panchazo/open-weather-station/docs/img/110-220_power_cable.jpg

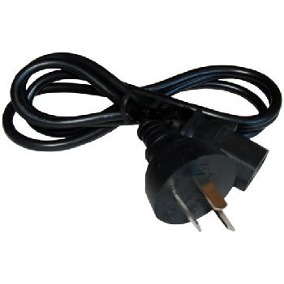
docs/img/110-220_power_cable.jpg
