panchazo/open-weather-station/docs/img/dual_usb_wall_socket_charger_module.jpg

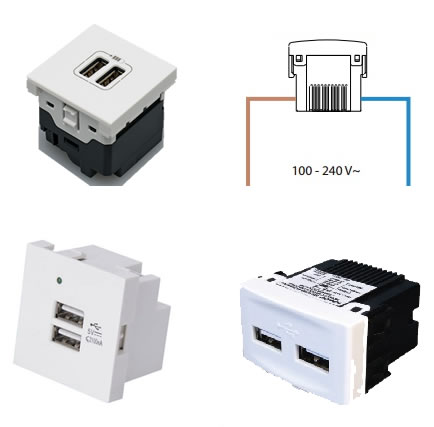
docs/img/dual_usb_wall_socket_charger_module.jpg
