panchazo/open-weather-station/docs/img/female_female_jumper_wires.jpg

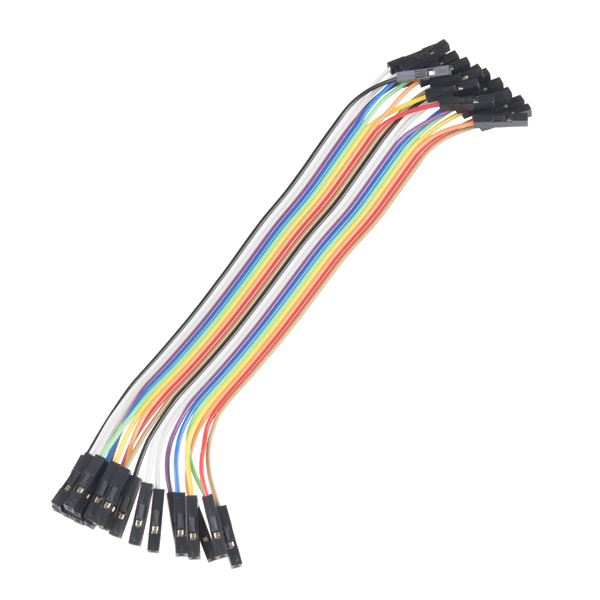
docs/img/female_female_jumper_wires.jpg
