panchazo/open-weather-station/docs/img/female_header_pins.jpg

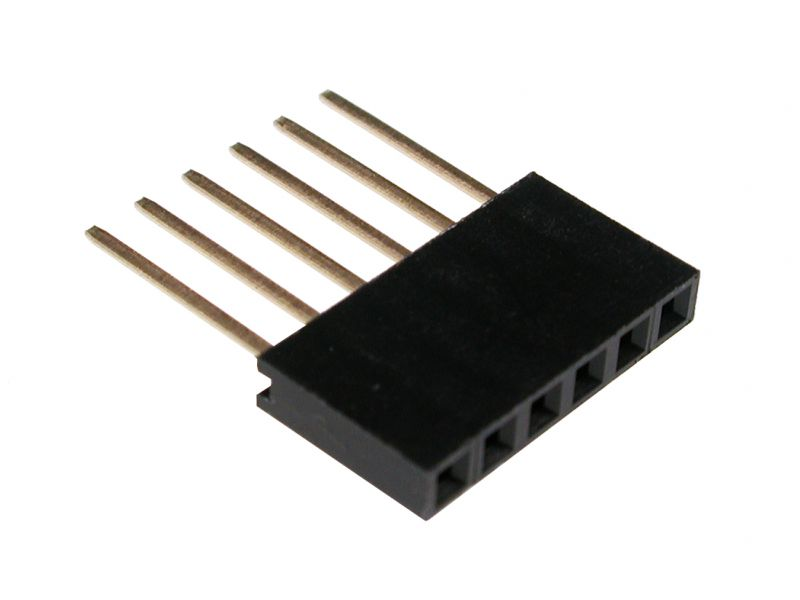
docs/img/female_header_pins.jpg
