panchazo/open-weather-station/docs/img/header_pins.jpg

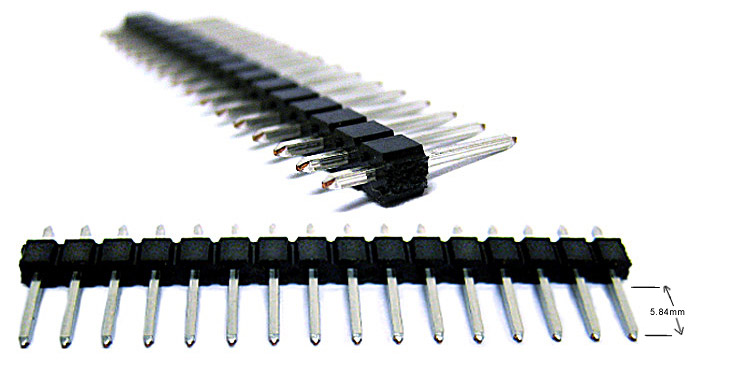
docs/img/header_pins.jpg
