panchazo/open-weather-station/docs/img/pcb_single_side_copper.jpg

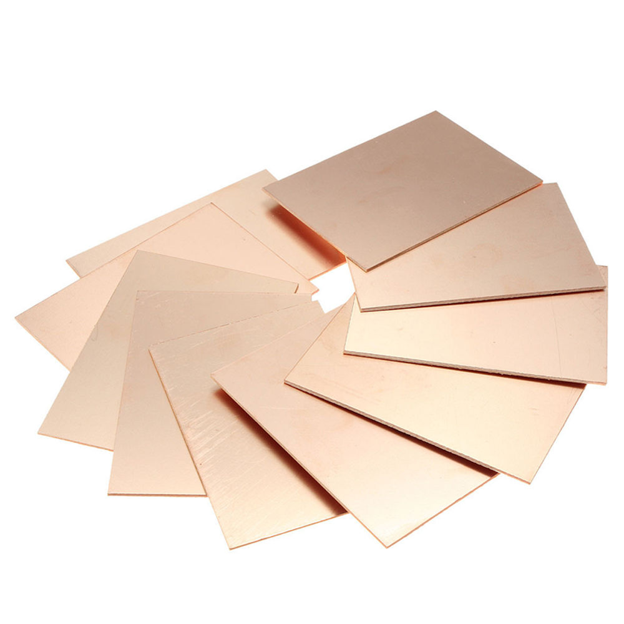
docs/img/pcb_single_side_copper.jpg
