panchazo/open-weather-station/docs/img/rj11_socket.jpg

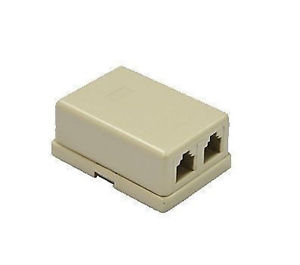
docs/img/rj11_socket.jpg
