panchazo/open-weather-station/docs/img/ws1080_anemometer.jpg

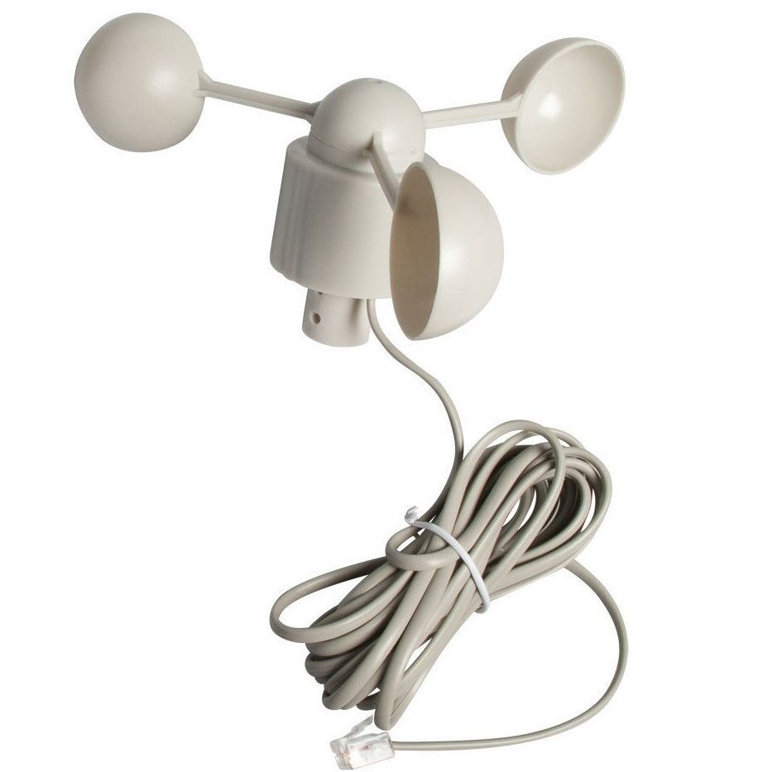
docs/img/ws1080_anemometer.jpg
