panchazo/open-weather-station/docs/img/ws1080_anemometer_windvane_support.jpg

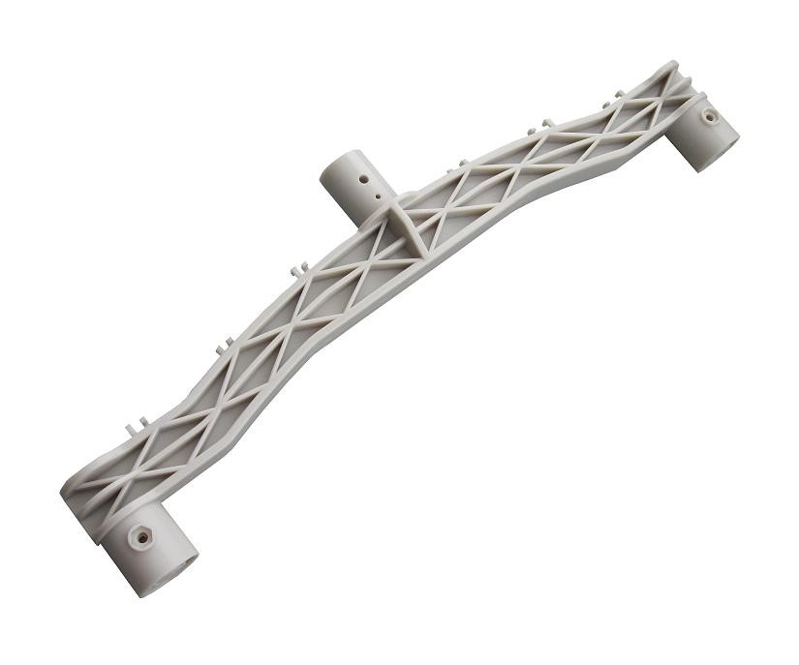
docs/img/ws1080_anemometer_windvane_support.jpg
