panchazo/open-weather-station/docs/img/ws1080_rain_gauge.jpg

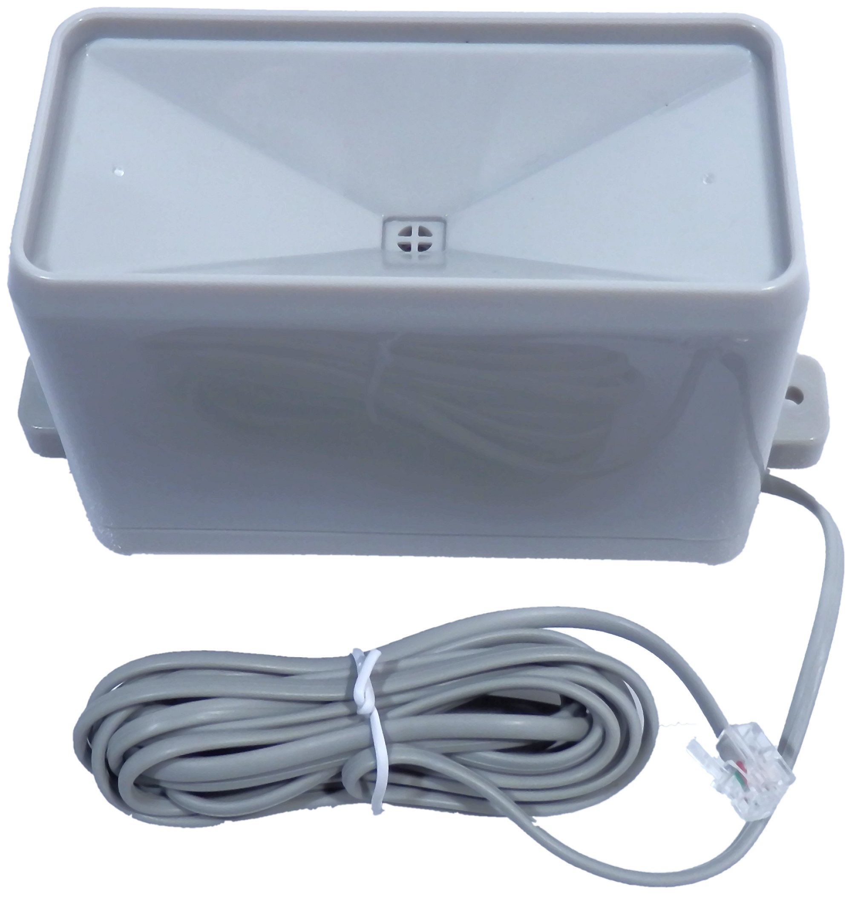
docs/img/ws1080_rain_gauge.jpg
