panchazo/open-weather-station/docs/img/ws1080_rain_gauge_support.jpg

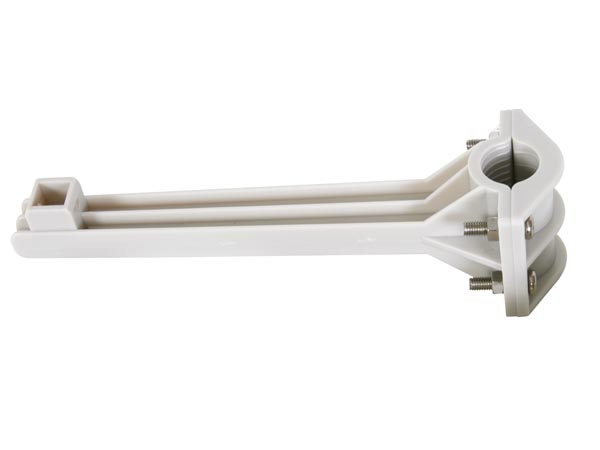
docs/img/ws1080_rain_gauge_support.jpg
