panchazo/open-weather-station/docs/img/ws1080_windvane.jpg

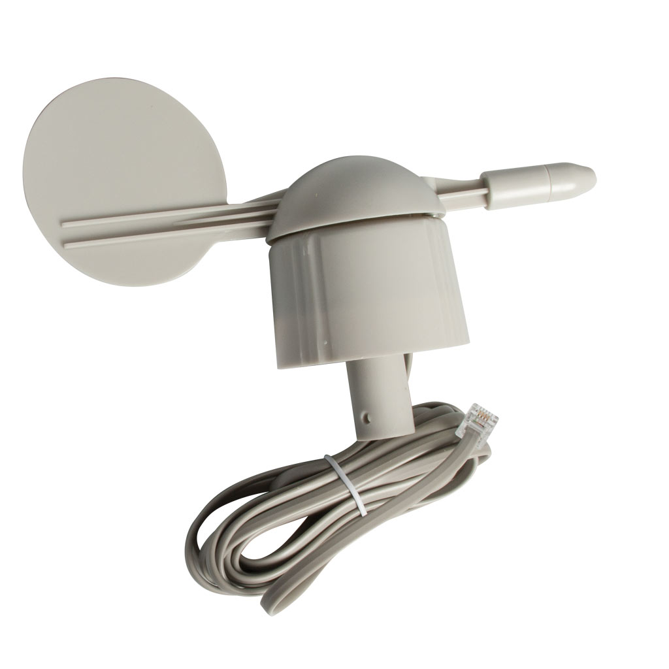
docs/img/ws1080_windvane.jpg
