panchazo/open-weather-station/docs/pcb printing sheet.pdf

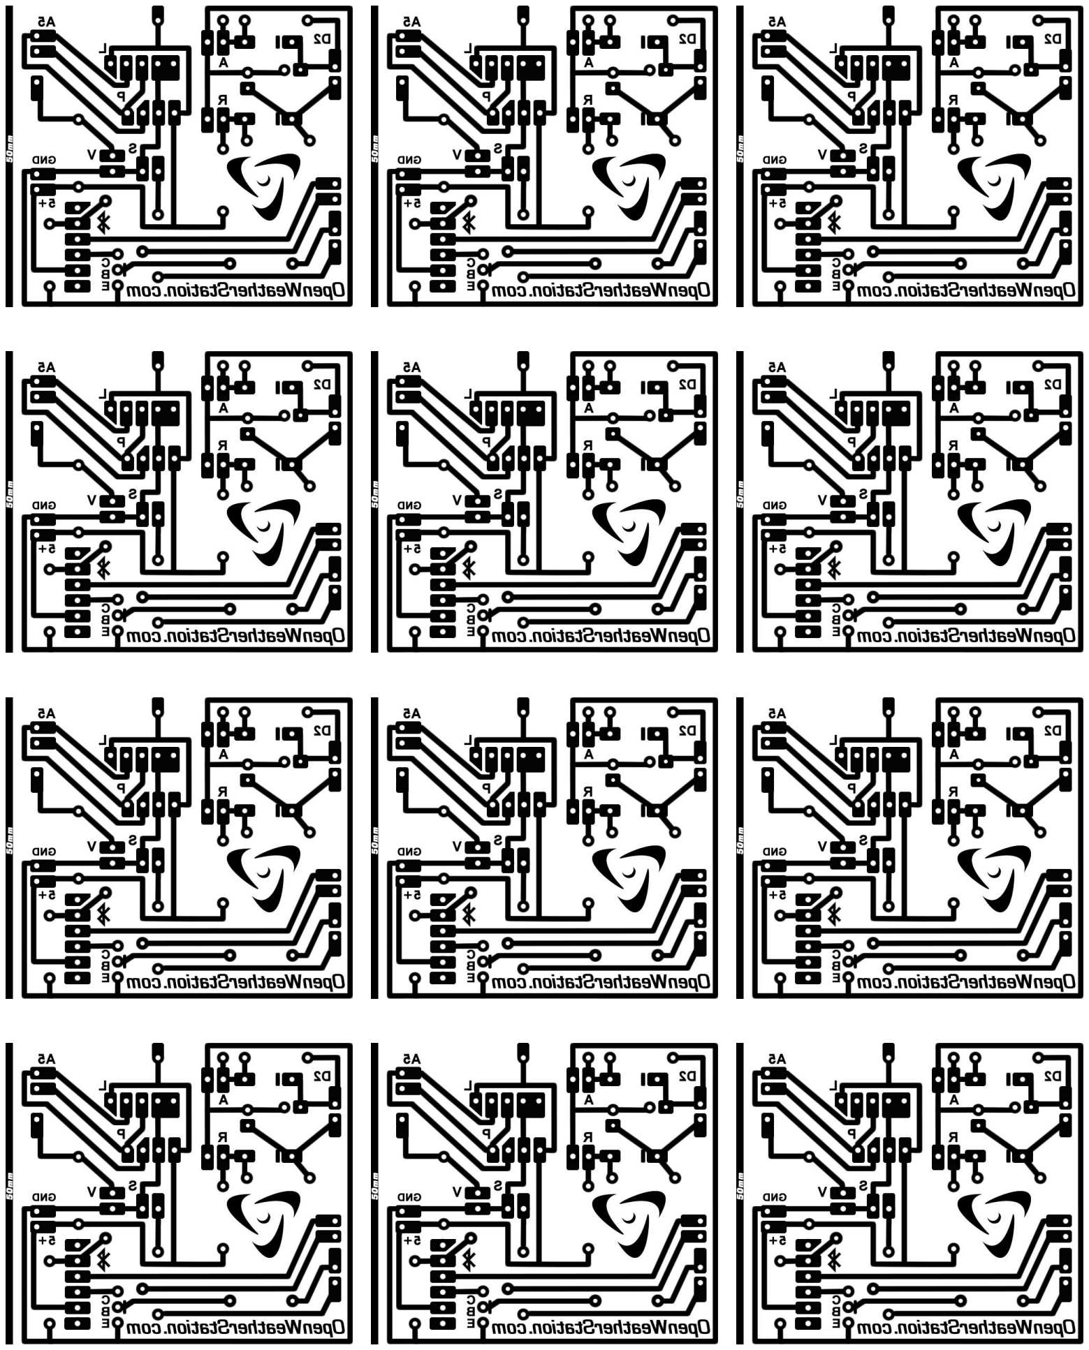
[picture p22: page 1]
