panchazo/open-weather-station/docs/img/assembly-step-by-step/1 - Etching and drilling/20180105_233544.jpg

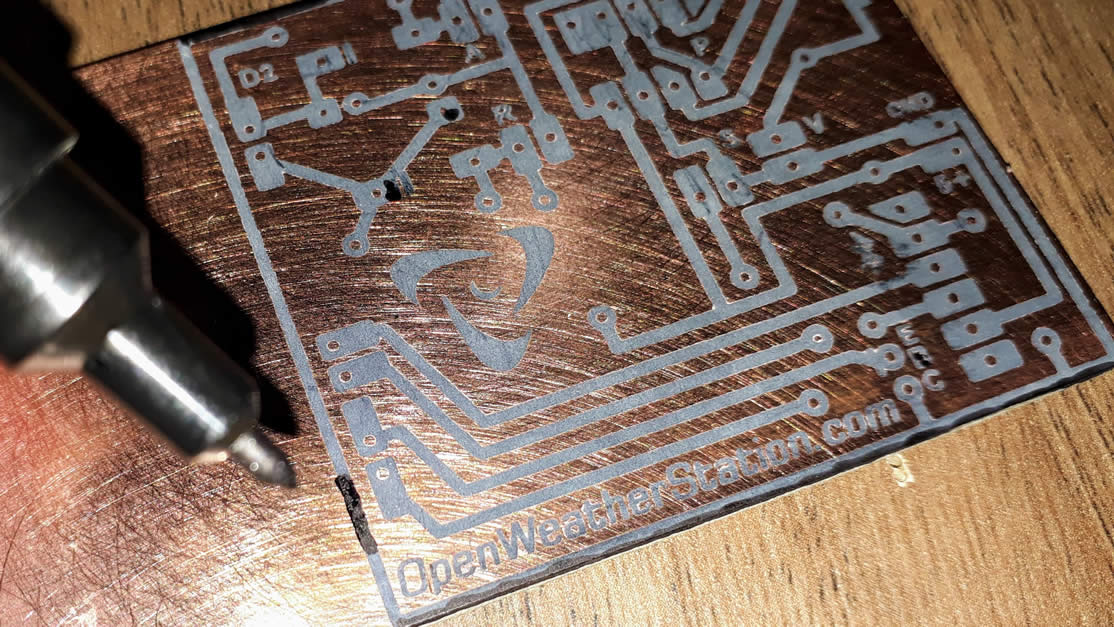
docs/img/assembly-step-by-step/1 - Etching and drilling/20180105_233544.jpg
