panchazo/open-weather-station/docs/img/assembly-step-by-step/1 - Etching and drilling/20180106_003709.jpg

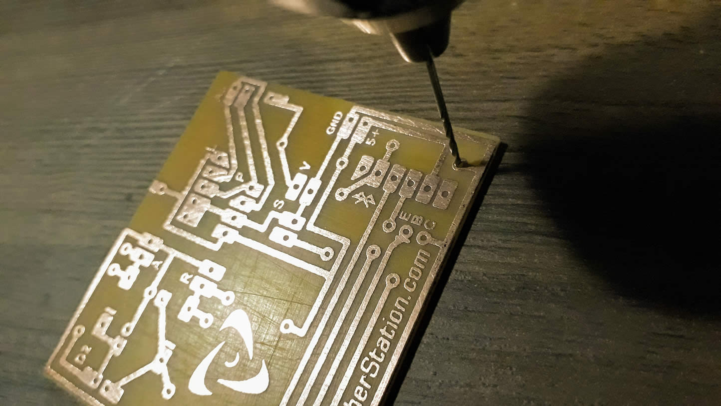
docs/img/assembly-step-by-step/1 - Etching and drilling/20180106_003709.jpg
