panchazo/open-weather-station/docs/img/assembly-step-by-step/1 - Etching and drilling/20180106_004929.jpg

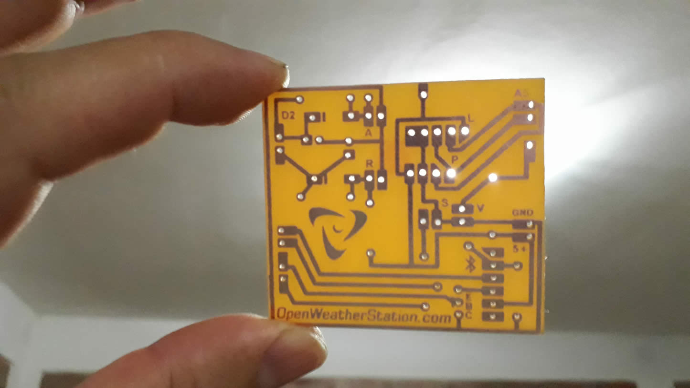
docs/img/assembly-step-by-step/1 - Etching and drilling/20180106_004929.jpg
