panchazo/open-weather-station/docs/img/assembly-step-by-step/2 - PCB header pins/20180106_012025.jpg

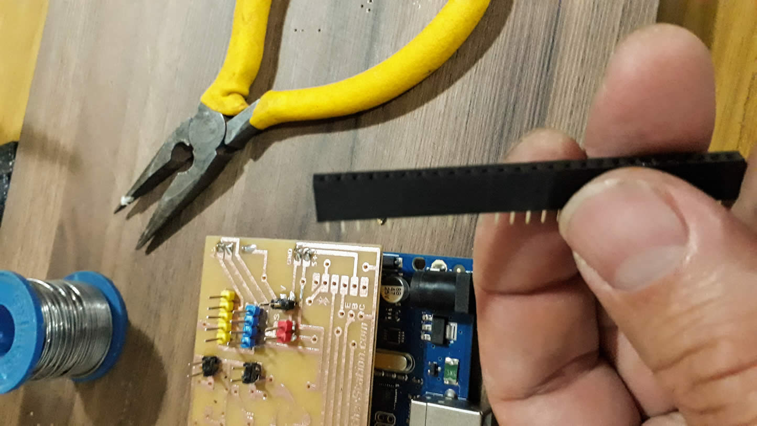
docs/img/assembly-step-by-step/2 - PCB header pins/20180106_012025.jpg
