panchazo/open-weather-station/docs/img/assembly-step-by-step/3 - Soldering components/20180106_014244.jpg

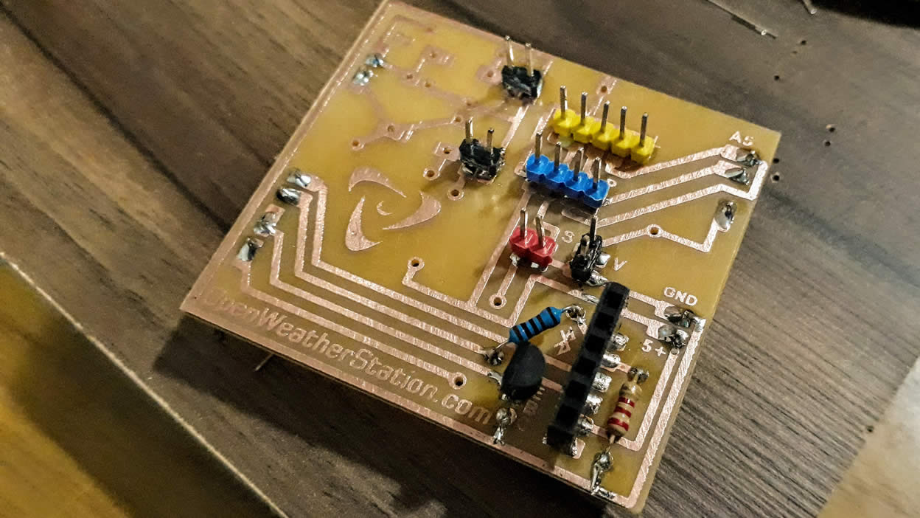
docs/img/assembly-step-by-step/3 - Soldering components/20180106_014244.jpg
