panchazo/open-weather-station/docs/img/assembly-step-by-step/4 - Wiring RJ11 Jack/20180106_000537.jpg

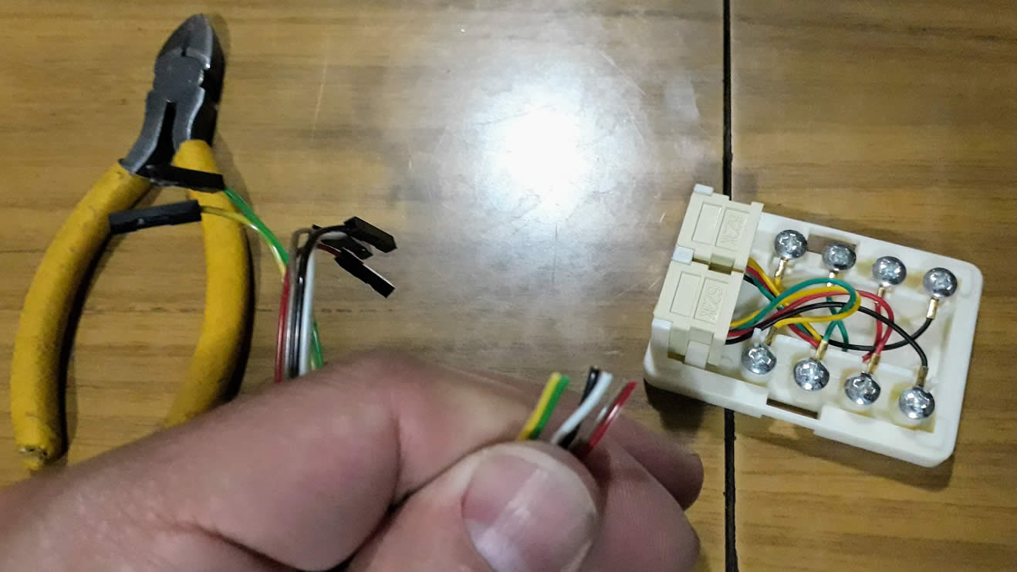
docs/img/assembly-step-by-step/4 - Wiring RJ11 Jack/20180106_000537.jpg
