panchazo/open-weather-station/docs/img/assembly-step-by-step/4 - Wiring RJ11 Jack/rj11_jack_and_cable.jpg

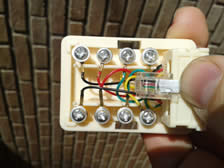
docs/img/assembly-step-by-step/4 - Wiring RJ11 Jack/rj11_jack_and_cable.jpg
