panchazo/open-weather-station/docs/img/assembly-step-by-step/4 - Wiring RJ11 Jack/rj11_jack_wiring_diagram.jpg

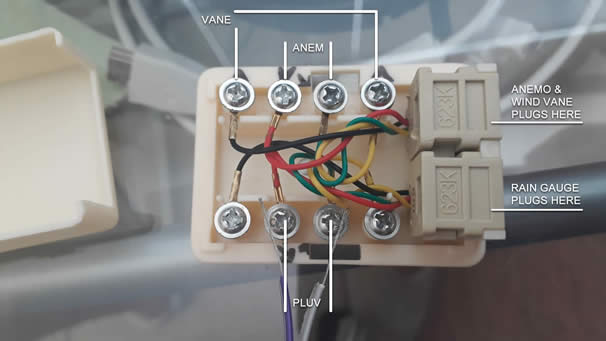
docs/img/assembly-step-by-step/4 - Wiring RJ11 Jack/rj11_jack_wiring_diagram.jpg
