panchazo/open-weather-station/docs/img/assembly-step-by-step/5 - Wire sensors and power/20180106_021313.jpg

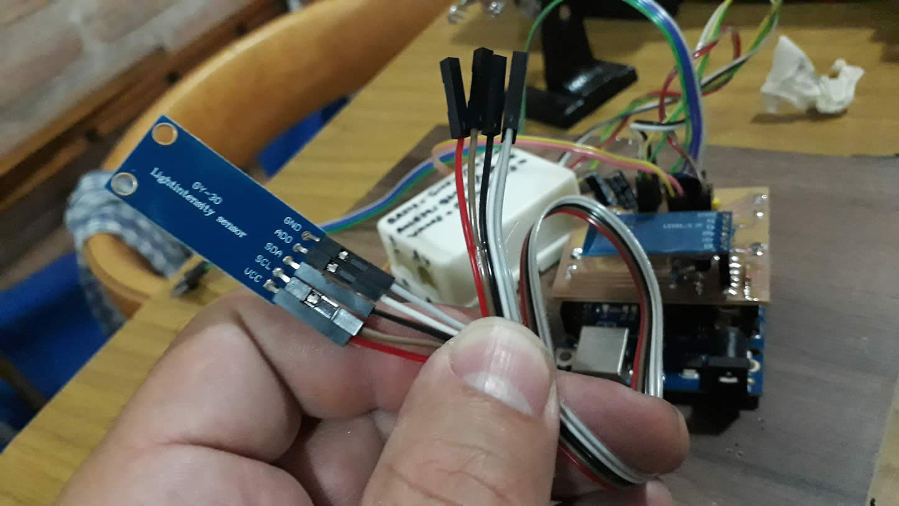
docs/img/assembly-step-by-step/5 - Wire sensors and power/20180106_021313.jpg
