panchazo/open-weather-station/docs/img/assembly-step-by-step/6 - Load code and connect via bluetooth/20180106_102910.jpg

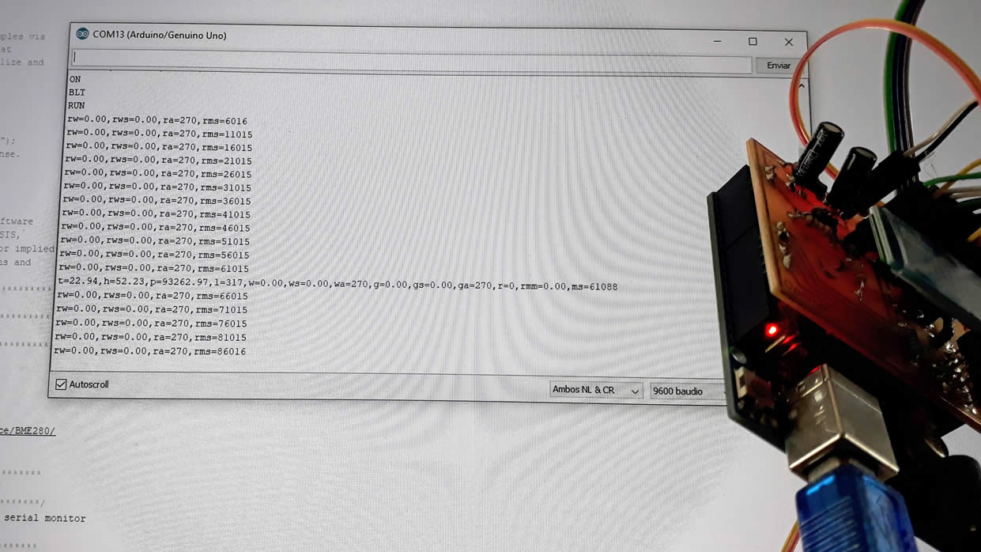
docs/img/assembly-step-by-step/6 - Load code and connect via bluetooth/20180106_102910.jpg
