panchazo/open-weather-station/docs/img/assembly-step-by-step/7 - connect via android/Screenshot_20180106-104611.jpg

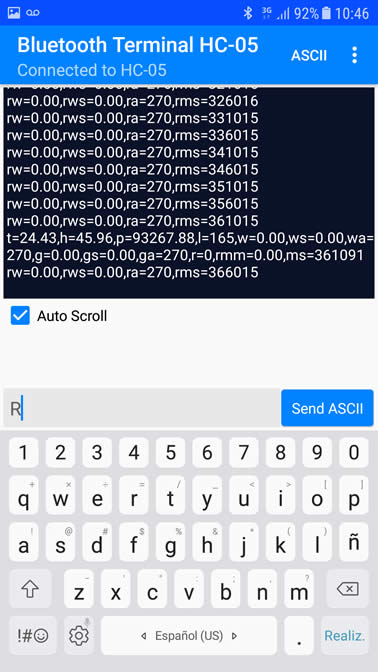
docs/img/assembly-step-by-step/7 - connect via android/Screenshot_20180106-104611.jpg
