panchazo/open-weather-station/docs/img/assembly-step-by-step/8 - Final preparation and housing/20180106_104130.jpg

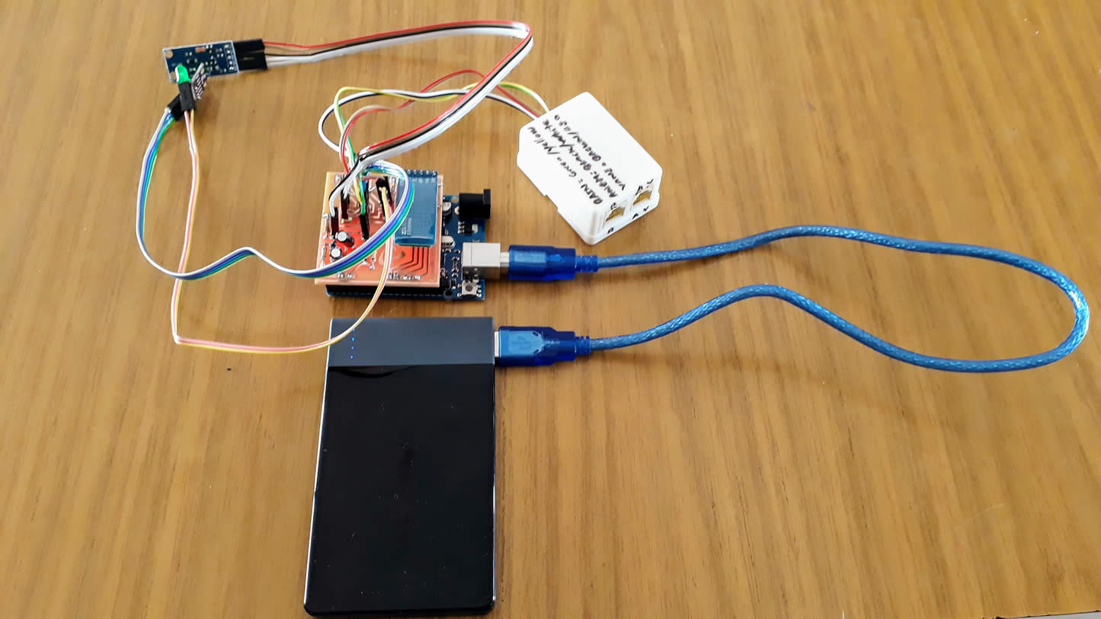
docs/img/assembly-step-by-step/8 - Final preparation and housing/20180106_104130.jpg
