panchazo/open-weather-station/(threads)

Thread 3 (2021-04-13):

Error Compiling Code

UAS-User, 2021-04-13:
I have all the libraries installed, updated, and in the correct folders, and have not changed the downloaded code at all, yet when I go to compile, I keep getting:

"   no matching function for call to 'SimpleTimer::setInterval(int, void (&)())'   "

There seems to be an issue with the SimpleTimer/timermanager portion of the code that I can't figure out.

panchazo, 2021-04-13:
Hi, the code is fine, you are just having some library issue, you will need to double check your Arduino libraries and also check that you are using a proper SimpleTimer library. Google is a better source of help on this regards. Best!

Closed 2021-04-13.

Thread 6 (2024-11-19):

APK Android ya no está disponible en Google Play

gabrielvgaona, 2024-11-19:
Es muy interesante este proyecto. Me gustaría crear una estación con mis estudiantes de meteorología. Pero al día de hoy, no se encuentra la aplicación en Google Play ¿Existe una versión de la APK disponible en algún otro sitio?

Muchas gracias por compartir todo esto.

panchazo, 2024-11-21:
Hola Gabriel, Google Play la bajó del store porque hace mucho no recibe
actualizaciones. Pero bajé el último paquete de instalación y ahora está
disponible en el repositorio en el branch master acá esta el link, desde
ahí podes bajar el apk e instalarlo manualmente en el celular:

https://github.com/panchazo/open-weather-station/tree/master/app

Espero les sea de utilidad,

Saludos!!
Fran

El mar, 19 nov 2024 a la(s) 5:34 p.m., Gabriel V. Gaona (
***@***.***) escribió:

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

gabrielvgaona, 2024-12-05:
Muchas gracias.

Closed 2024-11-21.
