panchazo/open-weather-station/arduino/arduino-libraries/BME280/src/BME280I2C.cpp

/*
BME280I2CI2C.cpp
This code records data from the BME280I2C sensor and provides an API.
This file is part of the Arduino BME280I2C library.
Copyright (C) 2016  Tyler Glenn

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
Written: Dec 30 2015.
Last Updated: Jan 1 2016. - Happy New year!

This header must be included in any derived code or copies of the code.

Based on the data sheet provided by Bosch for the BME280I2C environmental sensor,
calibration code based on algorithms providedBosch, some unit conversations courtesy
of www.endmemo.com, altitude equation courtesy of NOAA, and dew point equation
courtesy of Brian McNoldy at http://andrew.rsmas.miami.edu.
 */

#include <Wire.h>

#include "BME280I2C.h"


/****************************************************************/
BME280I2C::BME280I2C
(
  const Settings& settings
):BME280(settings),
  m_bme_280_addr(settings.bme280Addr)
{
}


/****************************************************************/
bool BME280I2C::WriteRegister
(
  uint8_t addr,
  uint8_t data
)
{
  Wire.beginTransmission(m_bme_280_addr);
  Wire.write(addr);
  Wire.write(data);
  Wire.endTransmission();

  return true; // TODO: Chech return values from wire calls.
}


/****************************************************************/
bool BME280I2C::ReadRegister
(
  uint8_t addr,
  uint8_t data[],
  uint8_t length
)
{
  uint8_t ord(0);

  Wire.beginTransmission(m_bme_280_addr);
  Wire.write(addr);
  Wire.endTransmission();

  Wire.requestFrom(m_bme_280_addr, length);

  while(Wire.available())
  {
    data[ord++] = Wire.read();
  }

  return ord == length;
}
