panchazo/open-weather-station/(commit log)

2018-01-08 complete readme assembly steps
2018-01-08 update assembly img
2018-01-08 update assembly img teaser
2018-01-10 added tips for power bank, charger and pcb finish
2018-01-16 readme update
    added clarification: measured pressure is absolute and not relative to sea level
2018-01-29 clarification about Arduino program constants
2018-01-29 Send computed windspeed and rain by default, send data via bluetooth as json, add a counter to distinguish samples requested from log history
2018-01-29 Added new 1kOhm resistor to list of materials
2018-01-29 improved bluetooth feed circuit to reduce arduino current drain
2018-03-09 line to detect proper pressure sensor version
2018-06-11 Added part 1 of the youtube video tutorials
    PCB preparation and drilling
2018-06-13 Added 3rd part video tutorial
    wiring, loading sketch and connecting to the app
2018-06-17 Added last part of the video tutorial
    How to prepare the outdoor housing for the station
2018-07-18 Add solar power tutorial
2018-07-18 Added spanish translation of solar power supply
2018-07-18 Updated solar power supply spanish translation
2018-11-26 incorporación de app de Remote Reboot (watchdog)
